bgkatz/Furuta-Pendulum/pendulum_input_board/board_1.JPG

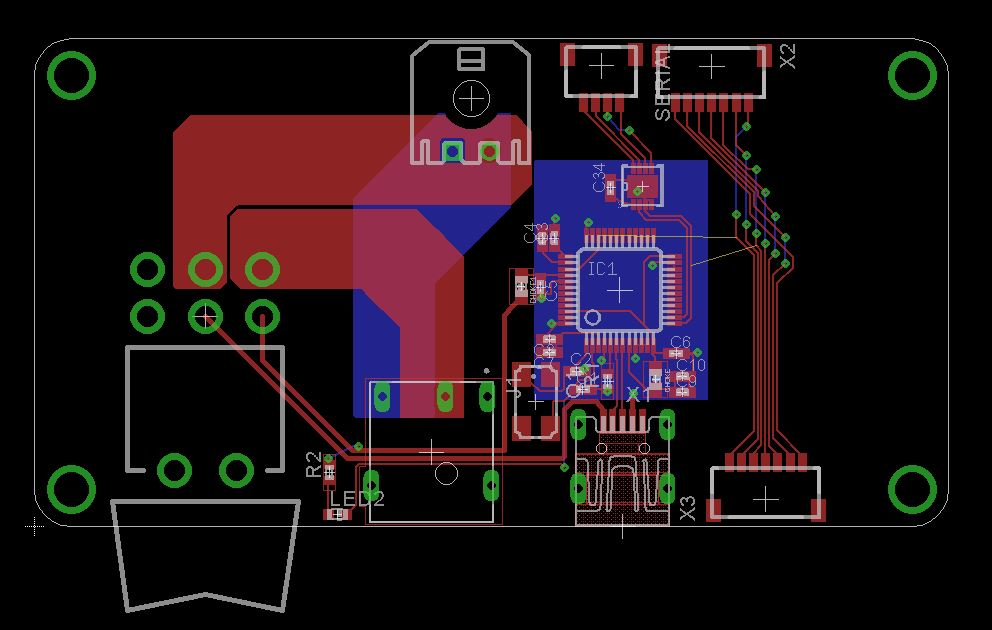
pendulum_input_board/board_1.JPG
