bgkatz/Furuta-Pendulum/pendulum_connector_board/board_1.JPG

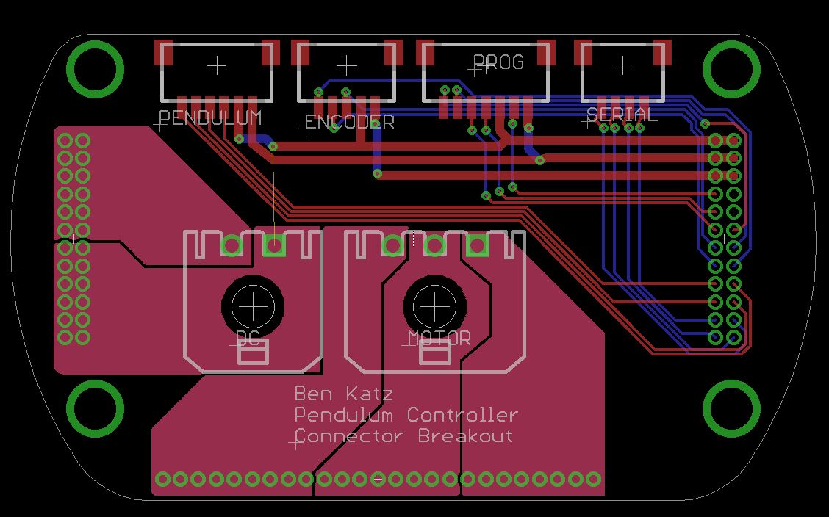
pendulum_connector_board/board_1.JPG
