bgkatz/Furuta-Pendulum/Pendulum Software/Python/pendulum_screenshot.JPG

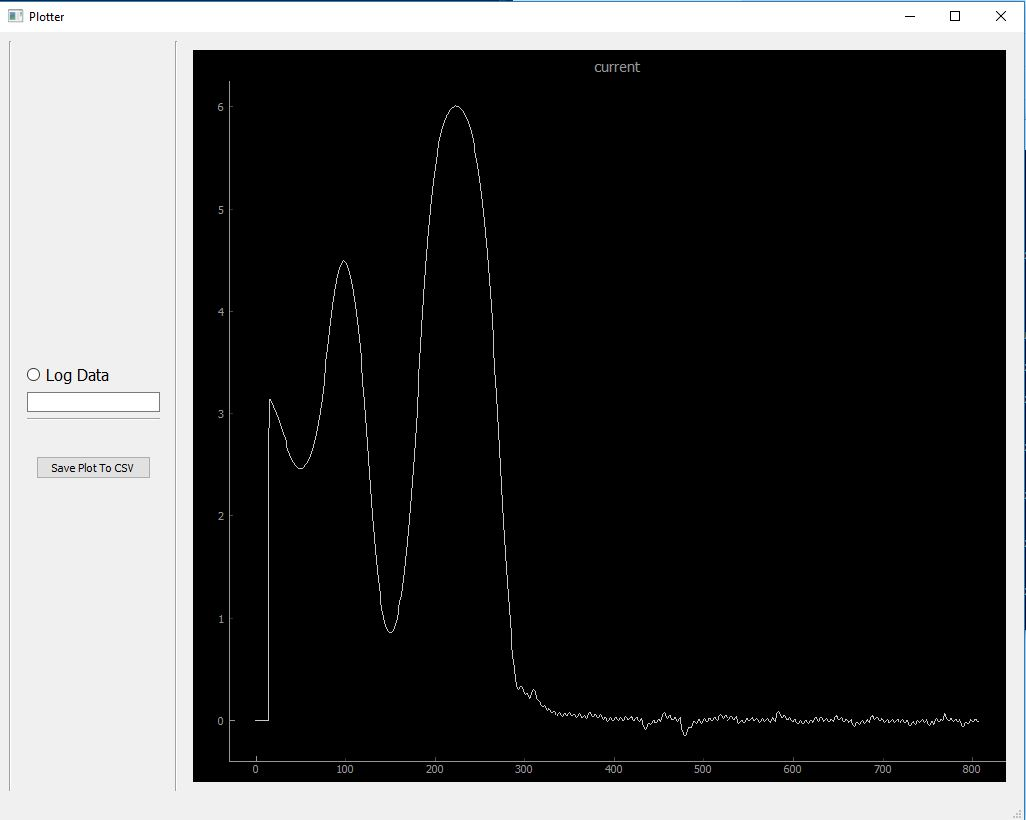
Pendulum Software/Python/pendulum_screenshot.JPG
