bgkatz/Furuta-Pendulum/pendulum_controller/board_1.JPG

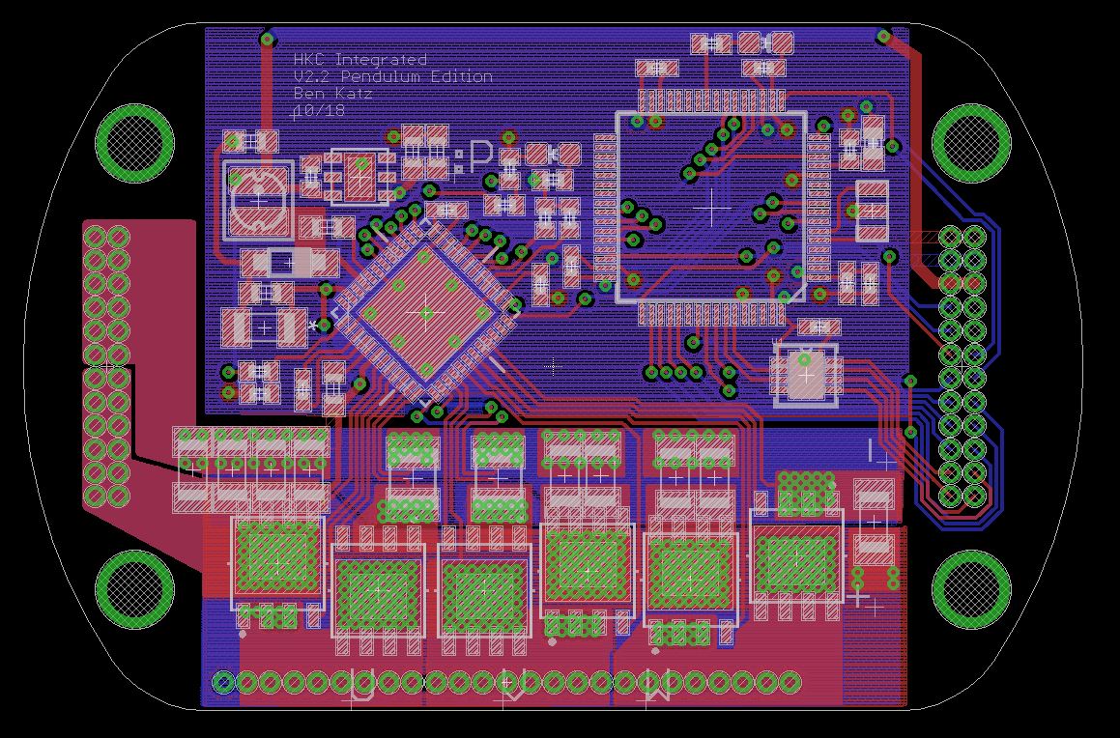
pendulum_controller/board_1.JPG
