bgkatz/Furuta-Pendulum/pendulum_connector_board/BOM_pendulum_connector_board.xlsx

Qty Per Board | Value | Device | Package | Parts | MFG | MFG Part
2 |  | CPOL-USE2.5-6 | E2,5-6 | C1, C2 | Panasonic Electronic Components | 35SEK47M
1 |  | HEADER_POS2_43650-0200 | 43650-0200 | DC | Molex | 436500200
1 |  | HEADER_POS3_43650-0300 | 43650-0300 | MOTOR | Molex | 436500300
1 | HEADER_1X25 | HEADER_1X25 | 1X25X.05 | U$4 | Harwin Inc. | M52-040023V2545
2 | HEADER_2X12 | HEADER_2X12 | 2X12X.05 | U$2, U$5 | Samtec Inc. | FTSH-112-01-F-D-ND
1 | SM02B-SRSS-TB | SM02B-SRSS-TB | SM02B-SRSS-TB | X4 | JST Sales America Inc. | SM02B-SRSS-TB(LF)(SN)
1 | SM04B-SRSS-TB | SM04B-SRSS-TB | SM04B-SRSS-TB | SERIAL | JST Sales America Inc. | SM04B-SRSS-TB(LF)(SN)
1 | SM05B-SRSS-TB | SM05B-SRSS-TB | SM05B-SRSS-TB | ENCODER | JST Sales America Inc. | SM05B-SRSS-TB(LF)(SN)
1 | SM06B-SRSS-TB | SM06B-SRSS-TB | SM06B-SRSS-TB | PENDULUM | JST Sales America Inc. | SM06B-SRSS-TB(LF)(SN)
1 | SM07B-SRSS-TB | SM07B-SRSS-TB | SM07B-SRSS-TB | X1 | JST Sales America Inc. | SM07B-SRSS-TB(LF)(SN)
