bgkatz/Furuta-Pendulum/pendulum_controller/BOM_pendulum_controller.xlsx

Qty Per Board | Value | Device | Package | Parts | MFG | MFG Part
1 |  | DIODE-SOD123 | SOD123 | D1 | Diodes Incorporated | MBR0580S1-7
2 | 0.001 | R-US_R1210 | R1210 | R6, R7 | Rohm Semiconductor | PMR25HZPFV1L00
8 | .1 uF | C-USC0402K | C0402K | C2, C4, C27, C31, C32, C34, C41, VREFCAP | Murata Electronics | GRM155R71H104KE14J
3 | 1 uF | C-USC0402K | C0402K | C7, C10, MC1 | Murata Electronics | GRM155R61E105KA12D
1 | 1 uF | C-USC0603K | C0603K | C6 | Samsung Electro-Mechanics | CL10A105KB8NNNC
10 | 10 uF | C-USC1206K | C1206K | C1, C8, C11, C12, C13, C14, C15, C16, C17, C18 | Murata Electronics | GRT31CR61H106ME01L
4 | 10k | R-US_R0402 | R0402 | R2, R3, R4, R27 | Yageo | RT0402DRE0710KL
1 | 150k | R-US_R0402 | R0402 | R26 | Stackpole Electronics Inc | RMCF0402FT150K
2 | 200 | R-US_R0402 | R0402 | R5, R22 | Yageo | RC0402JR-07200RL
3 | 22 uF | C-USC0603K | C0603K | C3 , C19, C20 | Samsung Electro-Mechanics | CL10A226MPCNUBE
1 | 22uH | SDR0302 | SDR0302 | L1 | Taiyo Yuden | NRH3012T220MN
1 | 4.7 uF | C-USC0402K | C0402K | C9 | Murata Electronics | GRM155R61A475MEAAD
1 | 47 nF | C-USC0402K | C0402K | C5 | TDK Corporation | CGA2B3X7R1H473K050BD
1 | 54.9k | R-US_R0402 | R0402 | R1 | Yageo | RC0402FR-0754K9L
1 | 600r | INDUCTOR0603 | 603 | CHOKE | Pulse Electronics Network | FERRITE BEAD 600 OHM 0603 1LN
1 | CSTCE | CSTCE | CSTCE | XT1 | Murata Electronics | CSTNE8M00GH5C000R0
1 | DRV8323RS | DRV8323RS | QFN50P700X700X90-49N | U$1 | Texas Instruments | DRV8323RSRGZR
2 | G | LED0603 | LED-0603 | LED1, LED2 | Lite-On Inc. | LTST-C191KRKT
1 | HEADER_1X25 | HEADER_1X25 | 1X25X.05 | U$4 | Harwin Inc. | M52-5002545
2 | HEADER_2X12 | HEADER_2X12 | 2X12X.05 | U$2, U$5 | Amphenol ICC (FCI) | 20021311-00024T4LF
1 | LDFM | LDFM | DFN6-3X3 | U$7 | STMicroelectronics | LDFM33PUR
1 | LTC2851MPDDPBF | LTC2851MPDDPBF | DFN-8_DD | U1 | Analog Devices Inc. | LTC2851MPDD#PBF
1 | STM32F446RET6 | STM32F446RET6 | TQFP64 | U$3 | STMicroelectronics | STM32F446RET6
6 | TPH | TPH | TRANS_TPH5900CNH,L1Q | Q1, Q2, Q3, Q4, Q5, Q6 | Toshiba Semiconductor and Storage | TPH7R204PL,LQ
