bgkatz/Furuta-Pendulum/pendulum_encoder_board/BOM.xlsx

Qty Per Board | Value | Device | Package | Parts | MFG | MFG Part
1 | 33µF | CPOL-USE2.5-5 | E2,5-5 | C2 | Panasonic Electronic Components | EEA-GA1A330H
1 | .1 uF | C-USC0402K | C0402K | C18 | Murata Electronics | GRM155R71H104KE14J
1 | MA700 | MA702 | QFN16 | U$11 | Monolithic Power Systems Inc. | MA702GQ-Z
1 | SM06B-SRSS-TB | SM06B-SRSS-TB | SM06B-SRSS-TB | PENDULUM | JST Sales America Inc. | SM06B-SRSS-TB(LF)(SN)
