bgkatz/Furuta-Pendulum/pendulum_input_board/BOM_pendulum_input_board.xlsx

Qty Per Board | Value | Device | Package | Parts | MFG | MFG Part
1 |  | CRYSTALCTS406 | CTS406 | Q1 | CTS-Frequency Controls | 406C35D12M00000
1 |  | HEADER_POS2_43650-0200 | 43650-0200 | DC | Molex | 436500200
1 |  | LEDCHIP-LED0603 | CHIP-LED0603 | LED2 | QT Brightek (QTB) | QBLP617-IW
7 | .1 uF | C-USC0402K | C0402K | C3, C4, C5, C6, C7, C9, C34 | Murata Electronics | GRM155R71H104KE14J
1 | 12k 1% | R-US_R0402 | R0402 | R1 | TE Connectivity Passive Product | CRGCQ0402F12K
2 | 18 pF | C-USC0402K | C0402K | C1, C2 | KEMET | C0402C180J8GAC7867
1 | 300 | R-US_R0402 | R0402 | R2 | Yageo | RC0402JR-07300RL
2 | 4.7 uF | C-USC0402K | C0402K | C8, C10 | Murata Electronics | GRM155R61A475MEAAD
3 | 600r | INDUCTOR0603 | 603 | CHOKE, CHOKE1, CHOKE2 | Pulse Electronics Network | FERRITE BEAD 600 OHM 0603 1LN
1 | FT232H | FT232H | LQFP48 | IC1 | FTDI, Future Technology Devices International Ltd | FT232HL-REEL
1 | LTC2851MPDDPBF | LTC2851MPDDPBF | DFN-8_DD | U1 | Analog Devices Inc. | LTC2851MPDD#PBF
1 | MINI-USB-UX60-MB-5S8 | MINI-USB-UX60-MB-5S8 | UX60-MB-5S8 | X1 | Hirose Electric Co Ltd | UX60-MB-5S8
1 | PJ-051BH | PJ-051BH | CUI_PJ-051BH | J1 | CUI Devices | PJ-051BH
1 | SM02B-SRSS-TB | SM02B-SRSS-TB | SM02B-SRSS-TB | X4 | JST Sales America Inc. | SM02B-SRSS-TB(LF)(SN)
1 | SM04B-SRSS-TB | SM04B-SRSS-TB | SM04B-SRSS-TB | SERIAL | JST Sales America Inc. | SM04B-SRSS-TB(LF)(SN)
2 | SM07B-SRSS-TB | SM07B-SRSS-TB | SM07B-SRSS-TB | X2, X3 | JST Sales America Inc. | SM07B-SRSS-TB(LF)(SN)
2 | SPDT | SPDT | 100SP | U$2, U$3 | E-Switch | 100SP1T2B4M6QE
