bgkatz/Furuta-Pendulum/pendulum_connector_board/pendulum_connector_board.brd

## EAGLE design pendulum_connector_board/pendulum_connector_board.brd (2020-09-17)

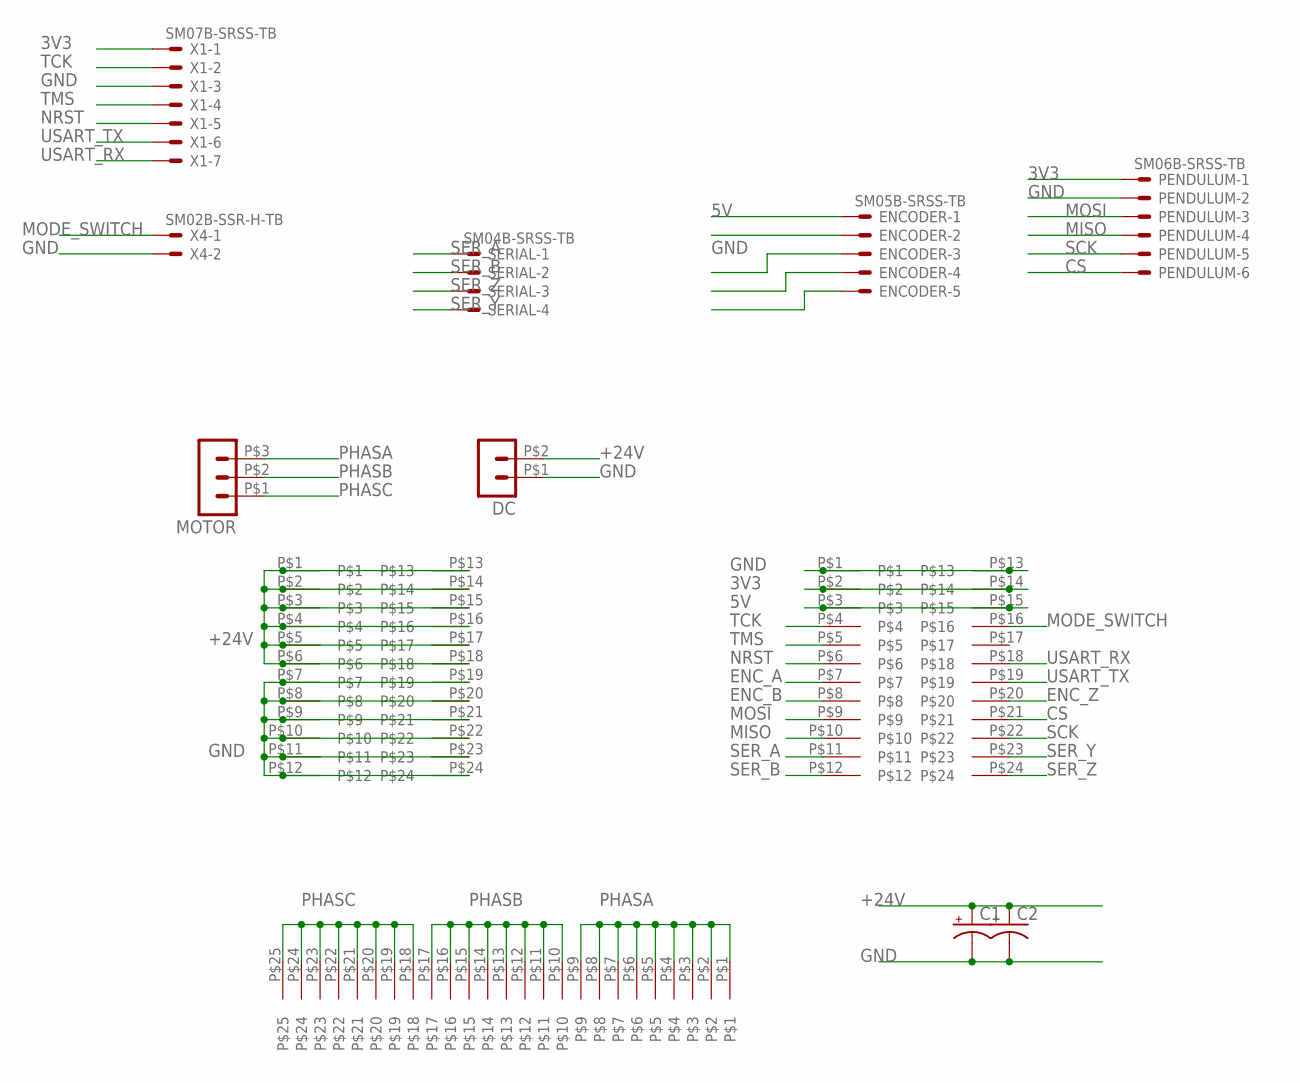
[picture p5: schematic pendulum_connector_board.sch]

Parts:
C1, C2: CPOL-USE2.5-6; E2,5-6
DC: HEADER_POS2_43650-0200; 43650-0200
ENCODER: SM05B-SRSS-TB
MOTOR: HEADER_POS3_43650-0300; 43650-0300
PENDULUM: SM06B-SRSS-TB
SERIAL: SM04B-SRSS-TB
U$2, U$5: HEADER_2X12; 2X12X.05
U$4: HEADER_1X25; 1X25X.05
X1: SM07B-SRSS-TB
X4: SM02B-SSR-H-TB

Connections:
3V3: PENDULUM.1, U$2.P$2, U$2.P$14, X1.1
5V: ENCODER.1, U$2.P$3, U$2.P$15
+24V: C1.+, C2.+, DC.P$2 (2), U$5.P$1, U$5.P$2, U$5.P$3, U$5.P$4, U$5.P$5, U$5.P$6, U$5.P$13, U$5.P$14, U$5.P$15, U$5.P$16, U$5.P$17, U$5.P$18
CS: PENDULUM.6, U$2.P$21
ENC_A: ENCODER.3, U$2.P$7
ENC_B: ENCODER.4, U$2.P$8
ENC_Z: ENCODER.5, U$2.P$20
GND: C1.-, C2.-, DC.P$1 (1), ENCODER.2, PENDULUM.2, U$2.P$1, U$2.P$13, U$5.P$7, U$5.P$8, U$5.P$9, U$5.P$10, U$5.P$11, U$5.P$12, U$5.P$19, U$5.P$20, U$5.P$21, U$5.P$22, U$5.P$23, U$5.P$24, X1.3, X4.2
MISO: PENDULUM.4, U$2.P$10
MODE_SWITCH: U$2.P$16, X4.1
MOSI: PENDULUM.3, U$2.P$9
NRST: U$2.P$6, X1.5
PHASA: MOTOR.P$3 (3), U$4.P$1, U$4.P$2, U$4.P$3, U$4.P$4, U$4.P$5, U$4.P$6, U$4.P$7, U$4.P$8, U$4.P$9
PHASB: MOTOR.P$2 (2), U$4.P$10, U$4.P$11, U$4.P$12, U$4.P$13, U$4.P$14, U$4.P$15, U$4.P$16, U$4.P$17
PHASC: MOTOR.P$1 (1), U$4.P$18, U$4.P$19, U$4.P$20, U$4.P$21, U$4.P$22, U$4.P$23, U$4.P$24, U$4.P$25
SCK: PENDULUM.5, U$2.P$22
SER_A: SERIAL.1, U$2.P$11
SER_B: SERIAL.2, U$2.P$12
SER_Y: SERIAL.4, U$2.P$23
SER_Z: SERIAL.3, U$2.P$24
TCK: U$2.P$4, X1.2
TMS: U$2.P$5, X1.4
USART_RX: U$2.P$18, X1.7
USART_TX: U$2.P$19, X1.6

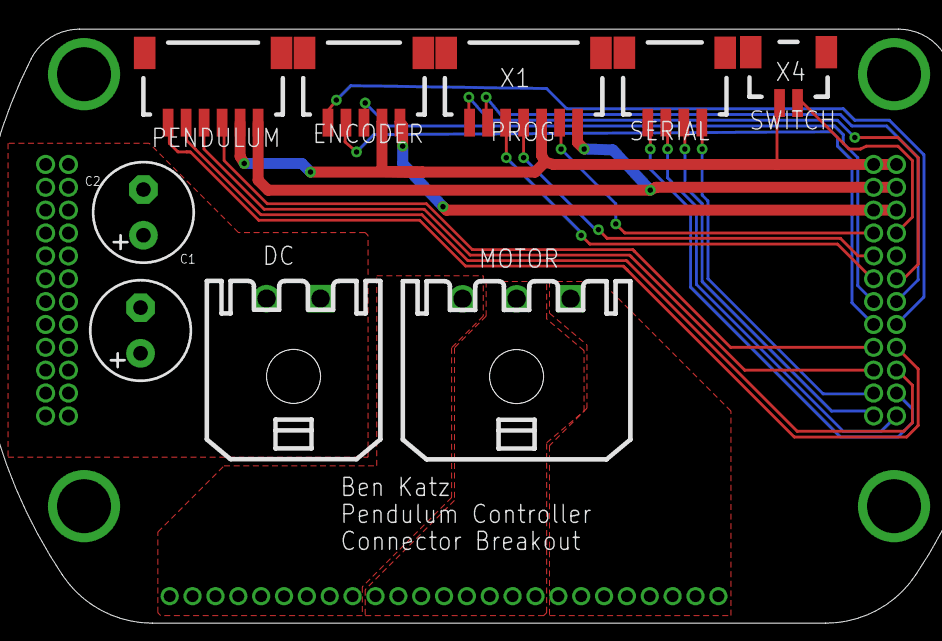
[picture p6: board pendulum_connector_board.brd from above]

Board: 2 copper layers, 12 parts (0 on the bottom side), 24 nets.
