bgkatz/Furuta-Pendulum/pendulum_controller/HKCV4.brd

## EAGLE design pendulum_controller/HKCV4.brd (2020-09-17)

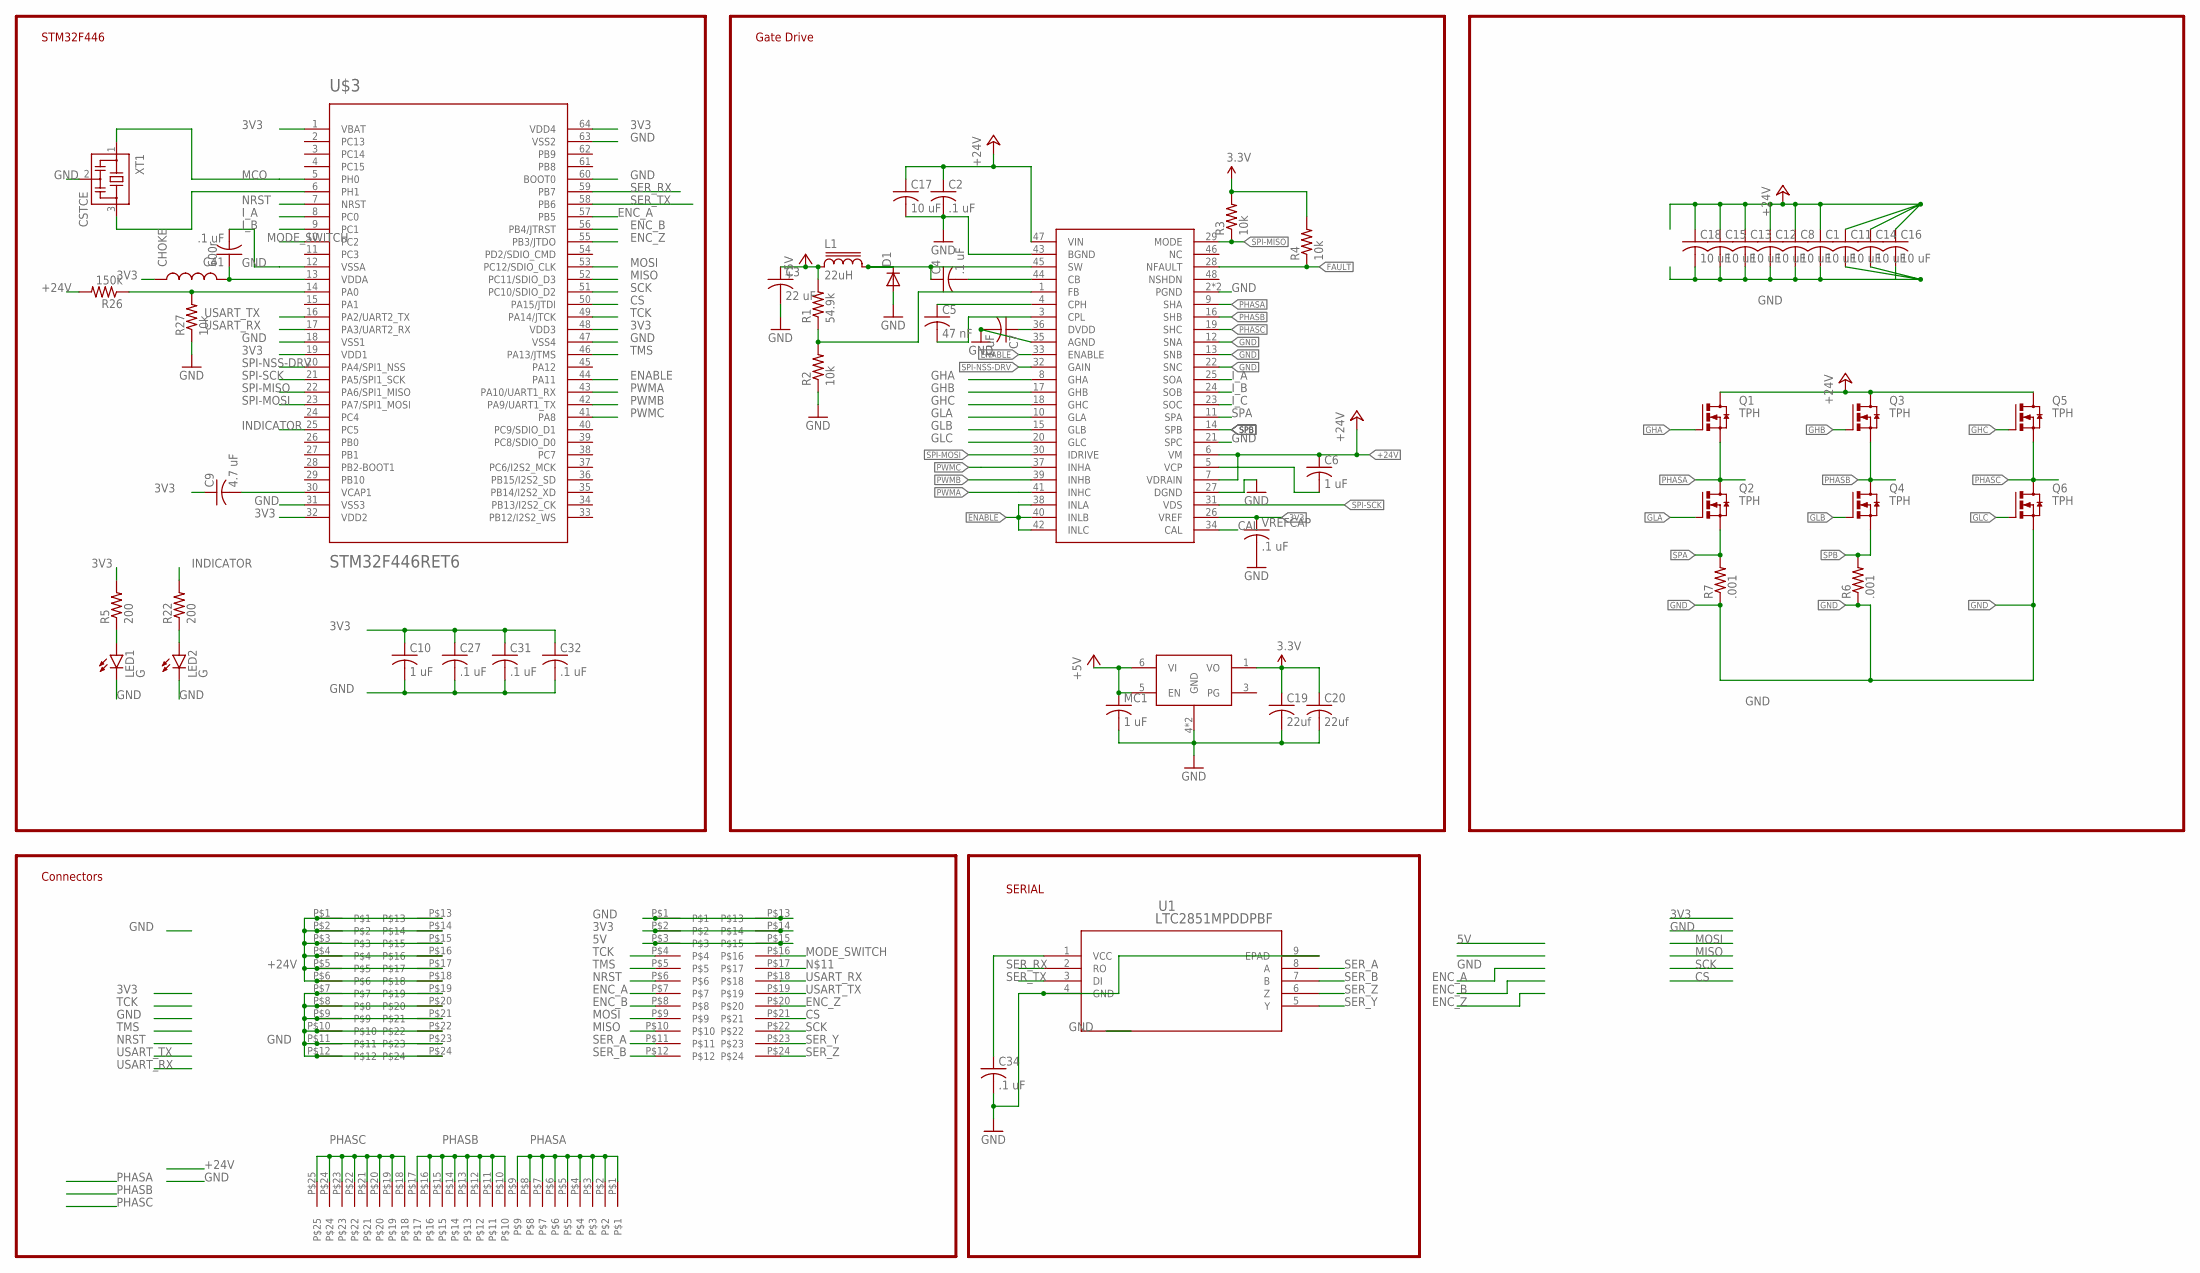
[picture p7: schematic HKCV4.sch]

Parts:
C1, C8, C11, C12, C13, C14, C15, C16, C17, C18: 10 uF; C1206K
C2, C4, C27, C31, C32, C34, C41: .1 uF; C0402K
C3: 22 uF; C0603K
C5: 47 nF; C0402K
C6: 1 uF; C0603K
C7, C10: 1 uF; C0402K
C9: 4.7 uF; C0402K
C19, C20: 22uf; C0603K
CHOKE: 600r; 0603
D1: DIODE-SOD123; SOD123
L1: 22uH; SDR0302
LED1, LED2: G; LED-0603
MC1: 1 uF; C0402K
Q1, Q2, Q3, Q4, Q5, Q6: TPH; TRANS_TPH5900CNH,L1Q
R1: 54.9k; R0402
R2, R3, R4, R27: 10k; R0402
R5, R22: 200; R0402
R6, R7: .001; R1210
R26: 150k; R0402
U1: LTC2851MPDDPBF; DFN-8_DD
U$1: DRV8323RH; QFN50P700X700X90-49N
U$2, U$5: HEADER_2X12; 2X12X.05
U$3: STM32F446RET6; TQFP64
U$4: HEADER_1X25; 1X25X.05
U$7: LDFM; DFN6-3X3
VREFCAP: .1 uF; C0402K
XT1: CSTCE

Connections:
3V3: C9.1, C10.1, C19.1, C20.1, C27.1, C31.1, C32.1, C34.1, CHOKE.1, R3.2, R4.2, R5.2, U1.1 (VCC), U$1.26 (VREF), U$2.P$2, U$2.P$14, U$3.1 (VBAT), U$3.19 (VDD1), U$3.32 (VDD2), U$3.48 (VDD3), U$3.64 (VDD4), U$7.1 (VO), VREFCAP.1
5V: C3.1, L1.1, MC1.1, R1.2, U$2.P$3, U$2.P$15, U$7.5 (EN), U$7.6 (VI)
+24V: C1.1, C2.1, C6.1, C8.1, C11.1, C12.1, C13.1, C14.1, C15.1, C16.1, C17.1, C18.1, Q1.5 (D), Q1.6 (D), Q1.7 (D), Q1.8 (D), Q1.EP (D), Q3.5 (D), Q3.6 (D), Q3.7 (D), Q3.8 (D), Q3.EP (D), Q5.5 (D), Q5.6 (D), Q5.7 (D), Q5.8 (D), Q5.EP (D), R26.2, U$1.6 (VM), U$1.7 (VDRAIN), U$1.47 (VIN), U$5.P$1, U$5.P$2, U$5.P$3, U$5.P$4, U$5.P$5, U$5.P$6, U$5.P$13, U$5.P$14, U$5.P$15, U$5.P$16, U$5.P$17, U$5.P$18
BOOT: C4.2, U$1.44 (CB)
CAL: U$1.34 (CAL)
CPH: C5.1, U$1.4 (CPH)
CPL: C5.2, U$1.3 (CPL)
CS: U$2.P$21, U$3.50 (PA15/JTDI)
DEVICE3.3: C7.1, U$1.36 (DVDD)
ENABLE: U$1.33 (ENABLE), U$1.38 (INLA), U$1.40 (INLB), U$1.42 (INLC), U$3.44 (PA11)
ENC_A: U$2.P$7, U$3.57 (PB5)
ENC_B: U$2.P$8, U$3.56 (PB4/JTRST)
ENC_Z: U$2.P$20, U$3.55 (PB3/JTDO)
FAULT: R4.1, U$1.28 (NFAULT)
FB: R1.1, R2.2, U$1.1 (FB)
GHA: Q1.4 (G), U$1.8 (GHA)
GHB: Q3.4 (G), U$1.17 (GHB)
GHC: Q5.4 (G), U$1.18 (GHC)
GLA: Q2.4 (G), U$1.10 (GLA)
GLB: Q4.4 (G), U$1.15 (GLB)
GLC: Q6.4 (G), U$1.20 (GLC)
GND: C1.2, C2.2, C3.2, C7.2, C8.2, C10.2, C11.2, C12.2, C13.2, C14.2, C15.2, C16.2, C17.2, C18.2, C19.2, C20.2, C27.2, C31.2, C32.2, C34.2, C41.2, D1.A, LED1.C, LED2.C, MC1.2, Q6.1 (S), Q6.2 (S), Q6.3 (S), R2.1, R6.1, R7.1, R27.1, U1.4 (GND), U1.9 (EPAD), U$1.2 (PGND), U$1.12 (SNA), U$1.13 (SNB), U$1.21 (SPC), U$1.22 (SNC), U$1.27 (DGND), U$1.35 (AGND), U$1.43 (BGND), U$1.49 (PGND), U$2.P$1, U$2.P$13, U$3.12 (VSSA), U$3.18 (VSS1), U$3.31 (VSS3), U$3.47 (VSS4), U$3.60 (BOOT0), U$3.63 (VSS2), U$5.P$7, U$5.P$8, U$5.P$9, U$5.P$10, U$5.P$11, U$5.P$12, U$5.P$19, U$5.P$20, U$5.P$21, U$5.P$22, U$5.P$23, U$5.P$24, U$7.4 (GND), U$7.EXP (GND), VREFCAP.2, XT1.2
INDICATOR: R22.2, U$3.25 (PC5)
I_A: U$1.25 (SOA), U$3.8 (PC0)
I_B: U$1.24 (SOB), U$3.9 (PC1)
I_C: U$1.23 (SOC)
MCO: U$3.5 (PH0), XT1.1
MISO: U$2.P$10, U$3.52 (PC11/SDIO_D3)
MODE_SWITCH: U$2.P$16, U$3.10 (PC2)
MOSI: U$2.P$9, U$3.53 (PC12/SDIO_CLK)
unnamed: LED1.A, R5.1
unnamed: C41.1, CHOKE.2, U$3.13 (VDDA)
unnamed: C9.2, U$3.30 (VCAP1)
unnamed: R26.1, R27.2, U$3.14 (PA0)
unnamed: LED2.A, R22.1
unnamed: U$3.6 (PH1), XT1.3
NRST: U$2.P$6, U$3.7 (NRST)
PHASA: Q1.1 (S), Q1.2 (S), Q1.3 (S), Q2.5 (D), Q2.6 (D), Q2.7 (D), Q2.8 (D), Q2.EP (D), U$1.9 (SHA), U$4.P$1, U$4.P$2, U$4.P$3, U$4.P$4, U$4.P$5, U$4.P$6, U$4.P$7, U$4.P$8, U$4.P$9
PHASB: Q3.1 (S), Q3.2 (S), Q3.3 (S), Q4.5 (D), Q4.6 (D), Q4.7 (D), Q4.8 (D), Q4.EP (D), U$1.16 (SHB), U$4.P$10, U$4.P$11, U$4.P$12, U$4.P$13, U$4.P$14, U$4.P$15, U$4.P$16, U$4.P$17
PHASC: Q5.1 (S), Q5.2 (S), Q5.3 (S), Q6.5 (D), Q6.6 (D), Q6.7 (D), Q6.8 (D), Q6.EP (D), U$1.19 (SHC), U$4.P$18, U$4.P$19, U$4.P$20, U$4.P$21, U$4.P$22, U$4.P$23, U$4.P$24, U$4.P$25
PWMA: U$1.41 (INHC), U$3.43 (PA10/UART1_RX)
PWMB: U$1.39 (INHB), U$3.42 (PA9/UART1_TX)
PWMC: U$1.37 (INHA), U$3.41 (PA8)
SCK: U$2.P$22, U$3.51 (PC10/SDIO_D2)
SER_A: U1.8 (A), U$2.P$11
SER_B: U1.7 (B), U$2.P$12
SER_RX: U1.2 (RO), U$3.59 (PB7)
SER_TX: U1.3 (DI), U$3.58 (PB6)
SER_Y: U1.5 (Y), U$2.P$23
SER_Z: U1.6 (Z), U$2.P$24
SPA: Q2.1 (S), Q2.2 (S), Q2.3 (S), R7.2, U$1.11 (SPA)
SPB: Q4.1 (S), Q4.2 (S), Q4.3 (S), R6.2, U$1.14 (SPB)
SPI-MISO: R3.1, U$1.29 (MODE), U$3.22 (PA6/SPI1_MISO)
SPI-MOSI: U$1.30 (IDRIVE), U$3.23 (PA7/SPI1_MOSI)
SPI-NSS-DRV: U$1.32 (GAIN), U$3.20 (PA4/SPI1_NSS)
SPI-SCK: U$1.31 (VDS), U$3.21 (PA5/SPI1_SCK)
SW: C4.1, D1.C, L1.2, U$1.45 (SW)
TCK: U$2.P$4, U$3.49 (PA14/JTCK)
TMS: U$2.P$5, U$3.46 (PA13/JTMS)
USART_RX: U$2.P$18, U$3.17 (PA3/UART2_RX)
USART_TX: U$2.P$19, U$3.16 (PA2/UART2_TX)
VCP: C6.2, U$1.5 (VCP)

Notes on the sheet:
Gate Drive
STM32F446
SERIAL
Connectors

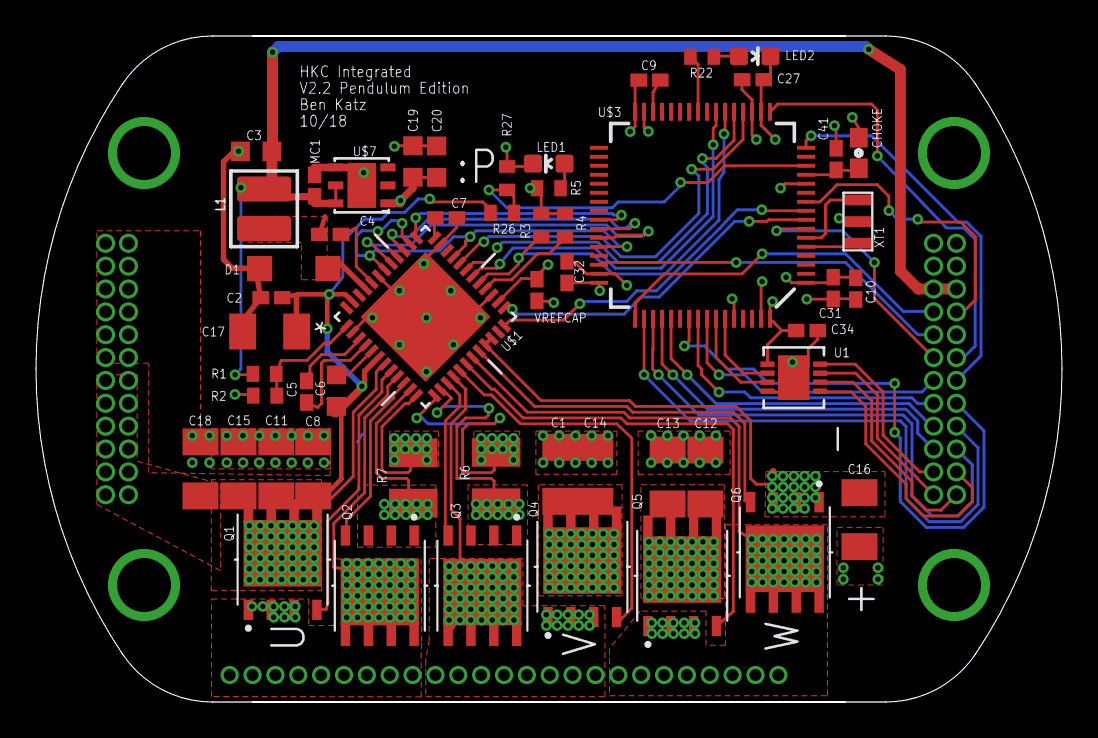
[picture p8: board HKCV4.brd from above]

Board: 4 copper layers, 57.0 x 37.0 mm, 56 parts (0 on the bottom side), 60 nets.
