bgkatz/Furuta-Pendulum/pendulum_input_board/pendulum_input_board.brd

## EAGLE design pendulum_input_board/pendulum_input_board.brd (2020-09-17)

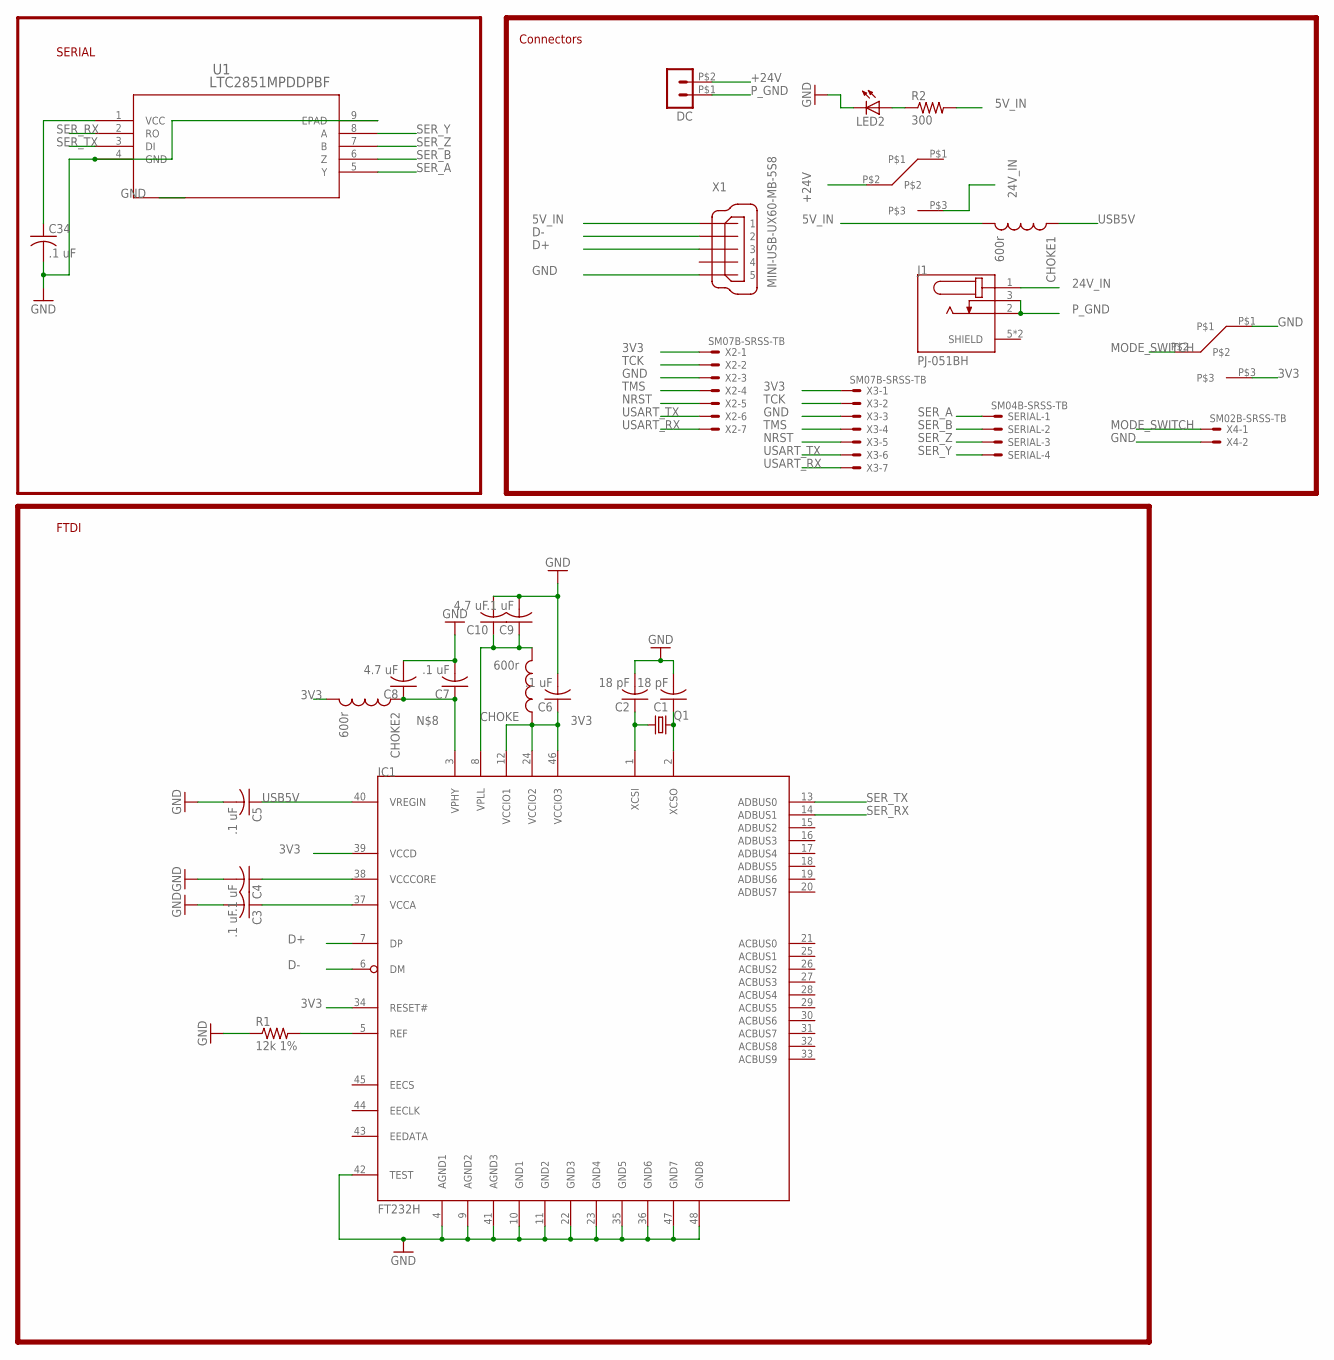
[picture p9: schematic pendulum_input_board.sch]

Parts:
C1, C2: 18 pF; C0402K
C3, C4, C5, C6, C7, C9, C34: .1 uF; C0402K
C8, C10: 4.7 uF; C0402K
CHOKE, CHOKE1, CHOKE2: 600r; 0603
DC: HEADER_POS2_43650-0200; 43650-0200
IC1: FT232H; LQFP48
J1: PJ-051BH; CUI_PJ-051BH
LED2: LEDCHIP-LED0603; CHIP-LED0603
Q1: CRYSTALCTS406; CTS406
R1: 12k 1%; R0402
R2: 300; R0402
SERIAL: SM04B-SRSS-TB
U1: LTC2851MPDDPBF; DFN-8_DD
U$2, U$3: SPDT; 100SP
X1: MINI-USB-UX60-MB-5S8; UX60-MB-5S8
X2, X3: SM07B-SRSS-TB
X4: SM02B-SRSS-TB

Connections:
3V3: C6.1, C34.1, CHOKE.1, CHOKE2.2, IC1.12 (VCCIO1), IC1.24 (VCCIO2), IC1.34 (RESET#), IC1.39 (VCCD), IC1.46 (VCCIO3), U1.1 (VCC), U$3.P$3, X2.1, X3.1
5V_IN: CHOKE1.2, R2.2, X1.1
24V_IN: J1.1, U$2.P$3
+24V: DC.P$2 (2), U$2.P$2
D+: IC1.7 (DP), X1.3
D-: IC1.6 (DM), X1.2
GND: C1.2, C2.2, C3.2, C4.2, C5.2, C6.2, C7.2, C8.2, C9.2, C10.2, C34.2, IC1.4 (AGND1), IC1.9 (AGND2), IC1.10 (GND1), IC1.11 (GND2), IC1.22 (GND3), IC1.23 (GND4), IC1.35 (GND5), IC1.36 (GND6), IC1.41 (AGND3), IC1.42 (TEST), IC1.47 (GND7), IC1.48 (GND8), LED2.C, R1.1, U1.4 (GND), U1.9 (EPAD), U$3.P$1, X1.5, X2.3, X3.3, X4.2
MODE_SWITCH: U$3.P$2, X4.1
unnamed: C9.1, C10.1, CHOKE.2, IC1.8 (VPLL)
unnamed: IC1.5 (REF), R1.2
unnamed: C2.1, IC1.1 (XCSI), Q1.1
unnamed: C1.1, IC1.2 (XCSO), Q1.3 (2)
unnamed: C4.1, IC1.38 (VCCCORE)
unnamed: C3.1, IC1.37 (VCCA)
unnamed: C7.1, C8.1, CHOKE2.1, IC1.3 (VPHY)
unnamed: LED2.A, R2.1
NRST: X2.5, X3.5
P_GND: DC.P$1 (1), J1.2, J1.3
SER_A: SERIAL.1, U1.5 (Y)
SER_B: SERIAL.2, U1.6 (Z)
SER_RX: IC1.14 (ADBUS1), U1.2 (RO)
SER_TX: IC1.13 (ADBUS0), U1.3 (DI)
SER_Y: SERIAL.4, U1.8 (A)
SER_Z: SERIAL.3, U1.7 (B)
TCK: X2.2, X3.2
TMS: X2.4, X3.4
USART_RX: X2.7, X3.7
USART_TX: X2.6, X3.6
USB5V: C5.1, CHOKE1.1, IC1.40 (VREGIN)

Notes on the sheet:
SERIAL
FTDI
Connectors

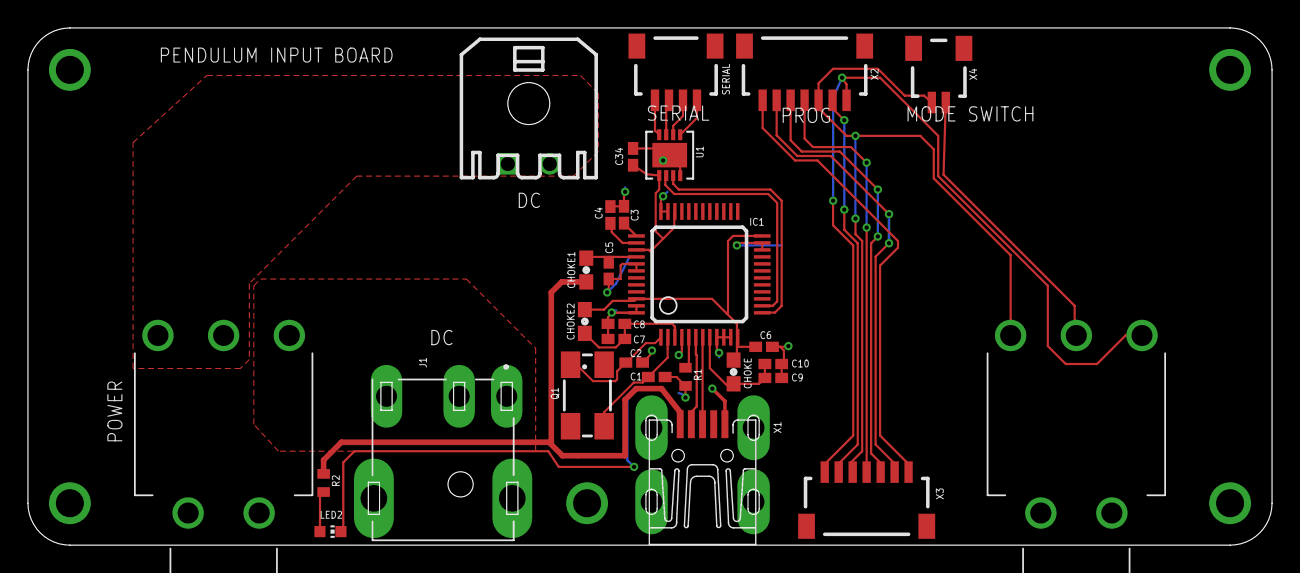
[picture p10: board pendulum_input_board.brd from above]

Board: 2 copper layers, 89.0 x 37.0 mm, 29 parts (0 on the bottom side), 29 nets.
