bgkatz/Furuta-Pendulum/pendulum_encoder_board/pendulum_encoder_board.brd

## EAGLE design pendulum_encoder_board/pendulum_encoder_board.brd (2020-09-17)

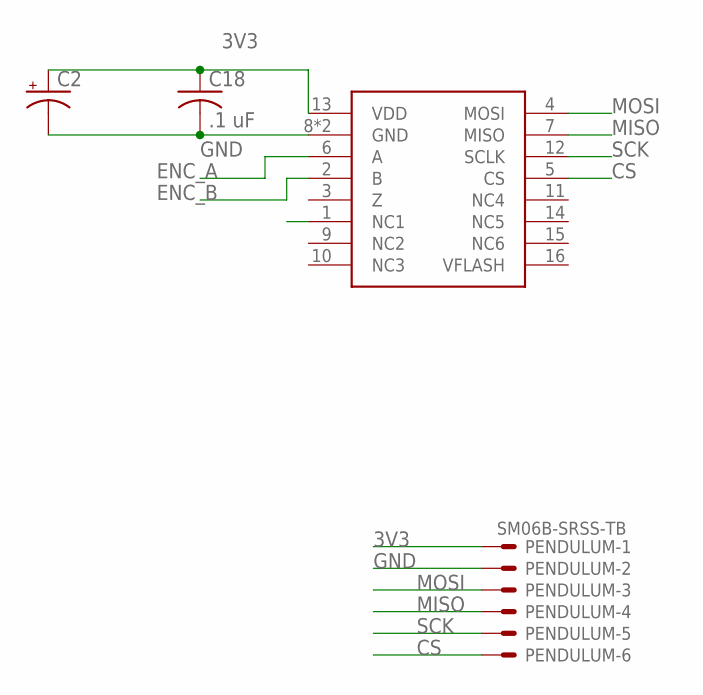
[picture p11: schematic pendulum_encoder_board.sch]

Parts:
C2: CPOL-USE2.5-5; E2,5-5
C18: .1 uF; C0402K
PENDULUM: SM06B-SRSS-TB
U$11: MA700; QFN16

Connections:
3V3: C2.+, C18.1, PENDULUM.1, U$11.13 (VDD)
CS: PENDULUM.6, U$11.5 (CS)
ENC_A: U$11.6 (A)
ENC_B: U$11.2 (B)
GND: C2.-, C18.2, PENDULUM.2, U$11.8 (GND), U$11.TH (GND)
MISO: PENDULUM.4, U$11.7 (MISO)
MOSI: PENDULUM.3, U$11.4 (MOSI)
SCK: PENDULUM.5, U$11.12 (SCLK)

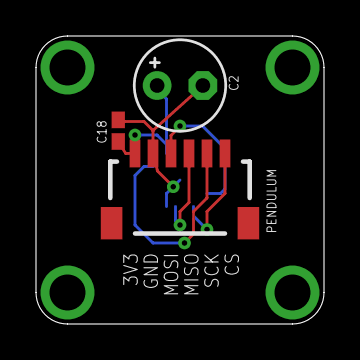
[picture p12: board pendulum_encoder_board.brd from above]

Board: 2 copper layers, 16.0 x 16.0 mm, 4 parts (1 on the bottom side), 6 nets.
