bgkatz/Furuta-Pendulum/(commit log)

2019-02-23 Adding all the 1st revision eagle files
    [HKCV4.brd, HKCV4.sch, pendulum_connector_board.brd, pendulum_connector_board.sch, pendulum_input_board.brd, pendulum_input_board.sch]
2019-03-04 minor changes
    [pendulum_connector_board.brd]
2019-05-07 Pendulum control demo in python
    [pendulum_connector_board.brd, pendulum_connector_board.sch, pendulum_input_board.brd, pendulum_input_board.sch]
2019-05-12 updated boards
    [HKCV4.brd, HKCV4.sch, pendulum_connector_board.brd, pendulum_connector_board.sch, pendulum_encoder_board.brd, pendulum_encoder_board.sch]
2019-11-06 updated pendulum software
    [pendulum_connector_board.brd, pendulum_input_board.brd, pendulum_input_board.sch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]
2020-06-10 added pendulum assembly step file
2020-09-17 fixing controller BOM mistake
    [BOM.xlsx, BOM_pendulum_connector_board.xlsx, BOM_pendulum_controller.xlsx, BOM_pendulum_input_board.xlsx, HKCV4.brd, HKCV4.sch, HKCV4_centroid.csv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]
