bgkatz/Furuta-Pendulum/(notices)

Notices in the files:
parts and their libraries:
SparkFun-Passives: Licensing: Creative Commons ShareAlike 4.0 International - https://creativecommons.org/licenses/by-sa/4.0
inductor-bourns: Copyright (C) 2008, Bob Starr
